richfacko-prog/rover1/3d/stl/upper_deck.stl

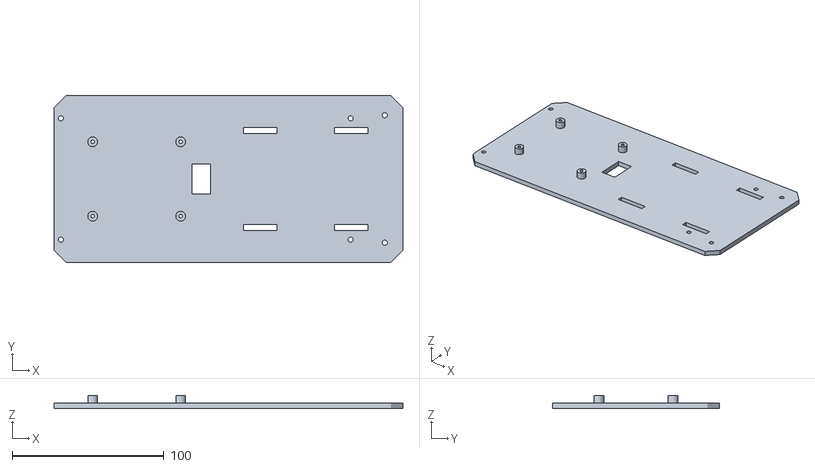
[picture p1: CAD file, 2026-11-14]
3d/stl/upper_deck.stl
230.0 x 110.0 x 8.50
