richfacko-prog/rover1/3d/stl/lower_deck.stl

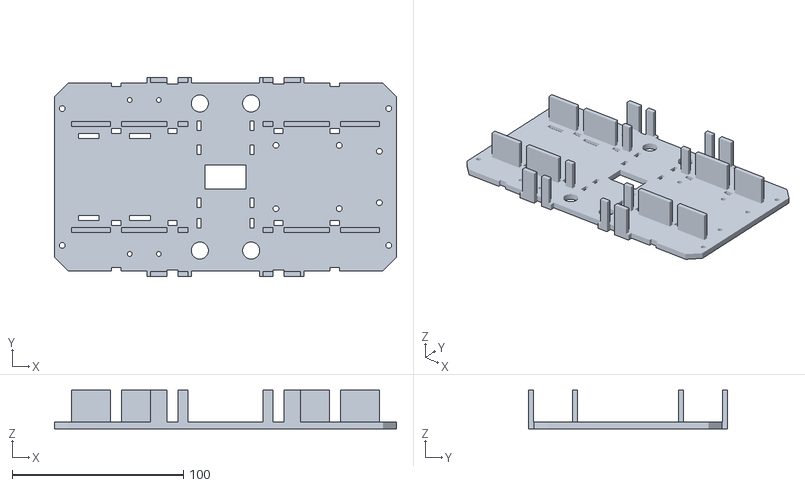
[picture p2: CAD file, 2026-11-13]
3d/stl/lower_deck.stl
200.0 x 116.6 x 22.8
