richfacko-prog/rover1/3d/stl/gauge_bracket.stl

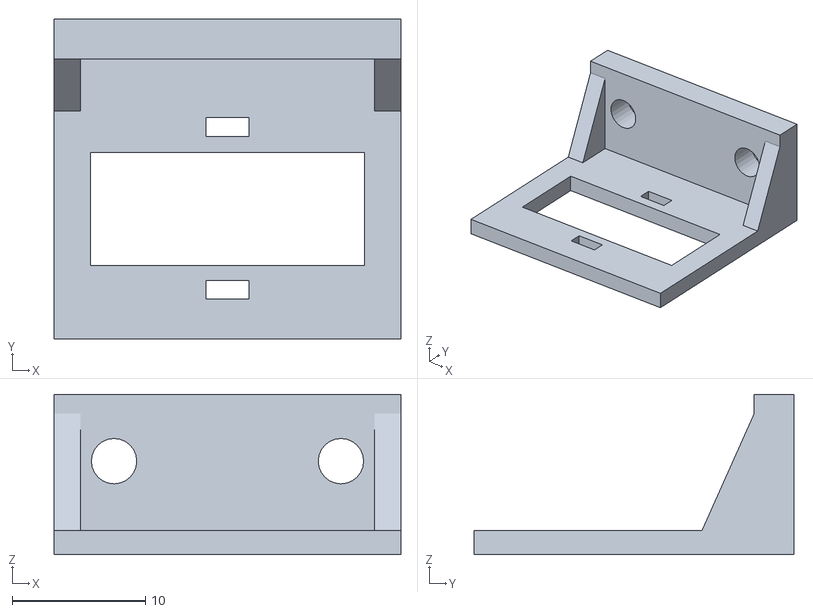
[picture p3: CAD file, 2026-11-12]
3d/stl/gauge_bracket.stl
26.0 x 24.0 x 12.0
