richfacko-prog/rover1/3d/stl/switch_bracket.stl

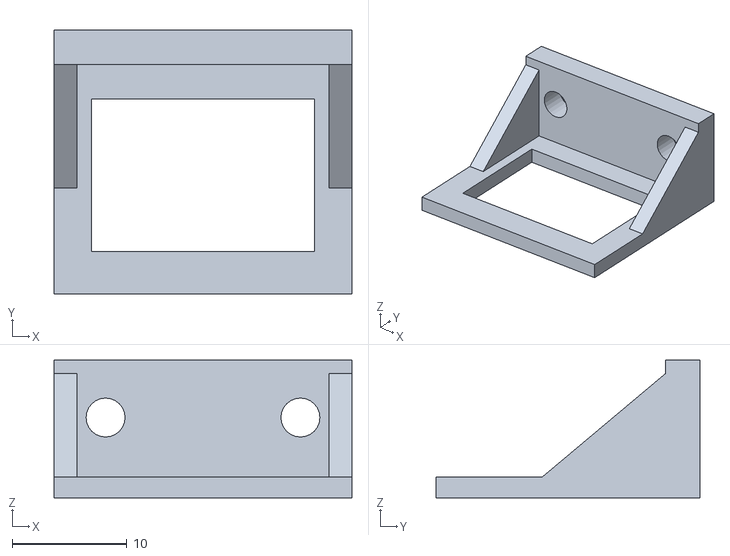
[picture p4: CAD file, 2026-11-12]
3d/stl/switch_bracket.stl
26.0 x 23.0 x 12.0
