richfacko-prog/rover1/3d/stl/pi_case_base.stl

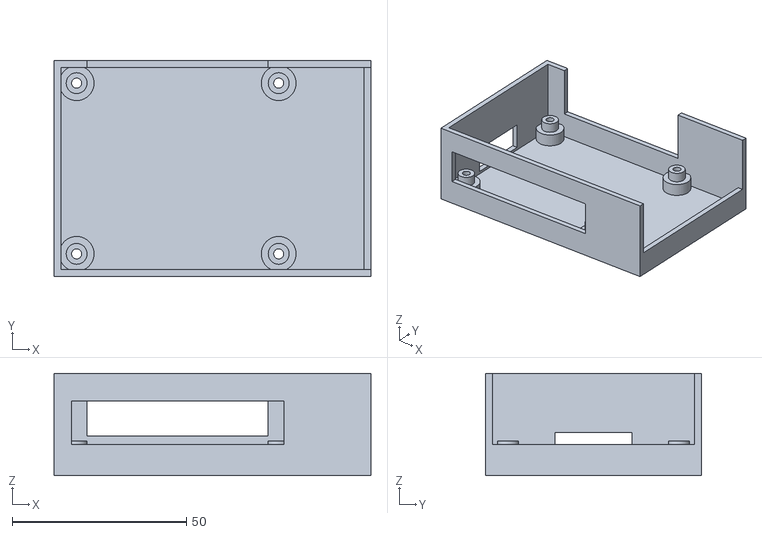
[picture p5: CAD file, 2026-11-09]
3d/stl/pi_case_base.stl
91.0 x 62.0 x 29.4
