richfacko-prog/rover1/3d/stl/deck_posts_x4.stl

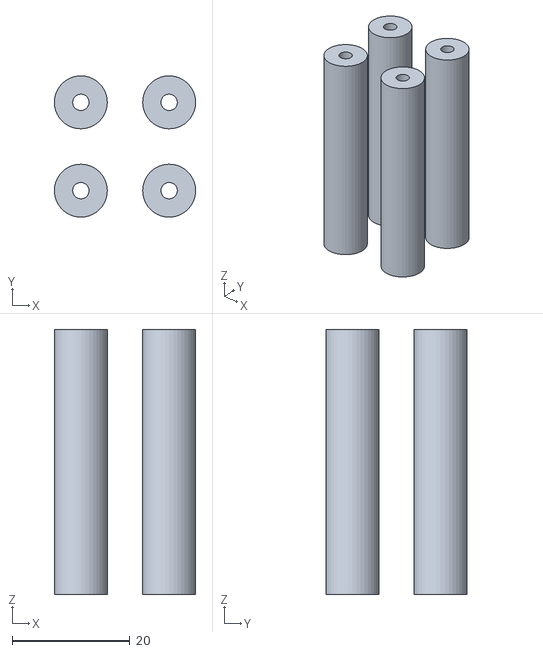
[picture p6: CAD file, 2026-11-09]
3d/stl/deck_posts_x4.stl
24.0 x 24.0 x 45.0
