richfacko-prog/rover1/3d/stl/tilt_bracket.stl

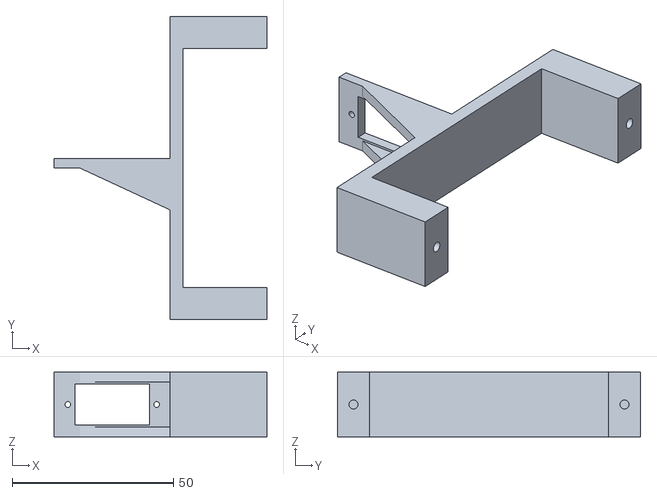
[picture p7: CAD file, 2026-11-09]
3d/stl/tilt_bracket.stl
66.0 x 94.0 x 20.0
