richfacko-prog/rover1/3d/stl/tilt_head.stl

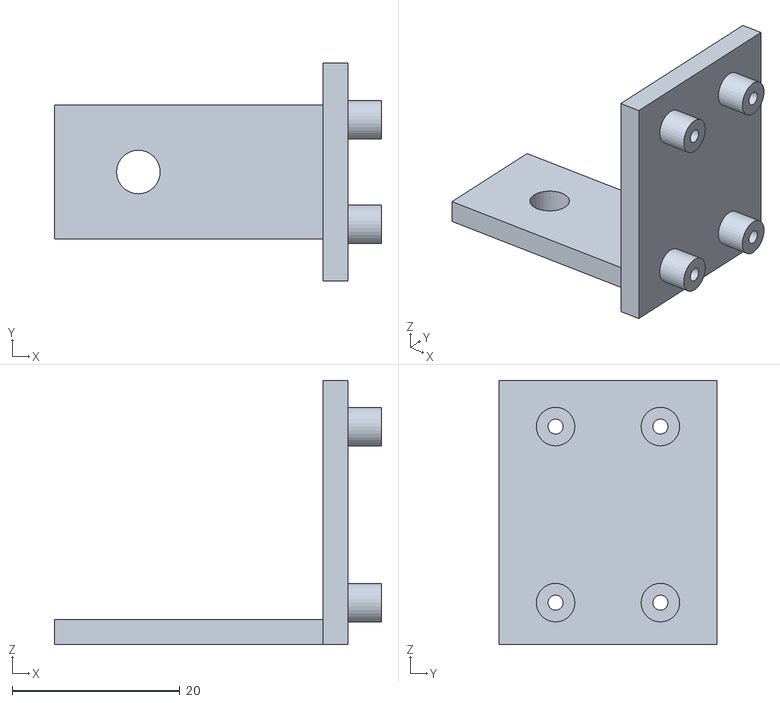
[picture p8: CAD file, 2026-11-09]
3d/stl/tilt_head.stl
39.0 x 26.0 x 31.5
