richfacko-prog/rover1/3d/stl/pi_case_lid.stl

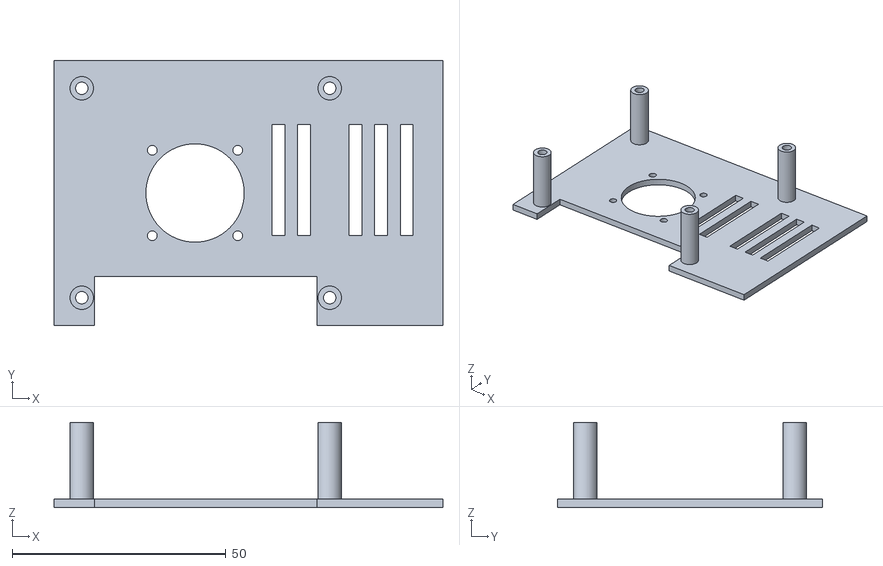
[picture p9: CAD file, 2026-11-09]
3d/stl/pi_case_lid.stl
91.0 x 62.0 x 20.0
