richfacko-prog/rover1/3d/stl/deck_posts_x2.stl

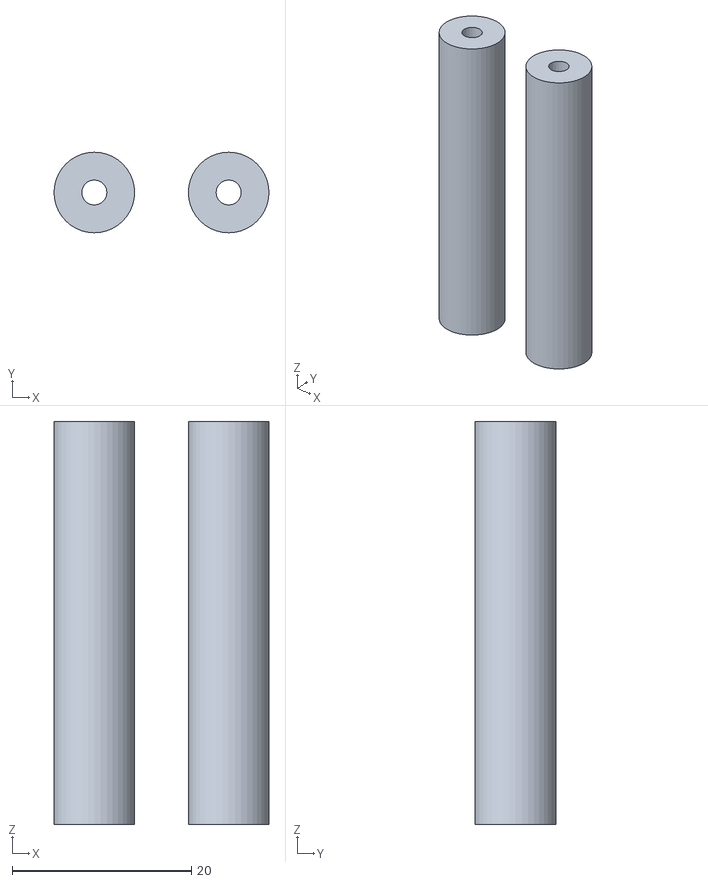
[picture p10: CAD file, 2026-11-09]
3d/stl/deck_posts_x2.stl
24.0 x 9.00 x 45.0
