richfacko-prog/rover1/3d/stl/camera_mount.stl

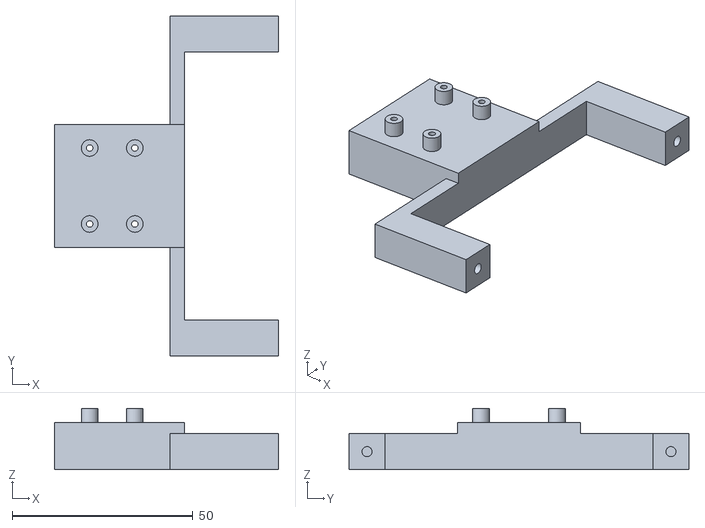
[picture p11: CAD file, 2026-11-09]
3d/stl/camera_mount.stl
62.0 x 94.0 x 17.0
