richfacko-prog/rover1/3d/stl/sensor_bracket.stl

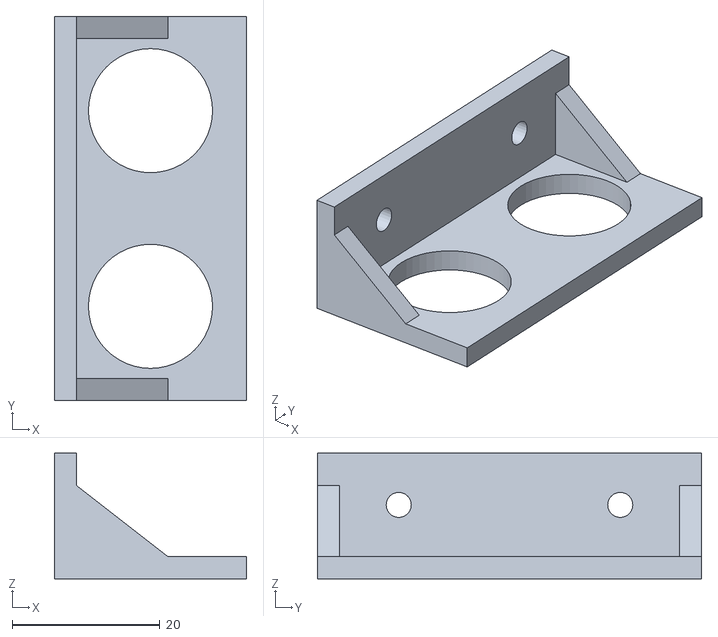
[picture p12: CAD file, 2026-11-09]
3d/stl/sensor_bracket.stl
26.0 x 52.0 x 17.0
