richfacko-prog/rover1/3d/stl/pi_case_bolt_lid.stl

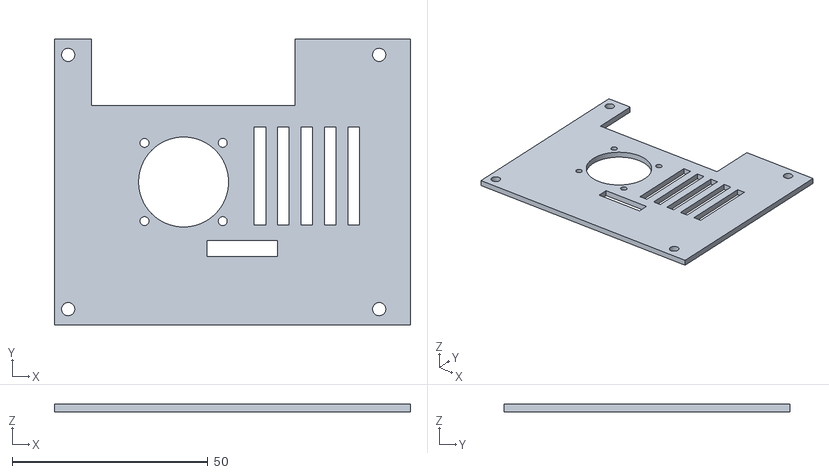
[picture p13: CAD file, 2026-11-10]
3d/stl/pi_case_bolt_lid.stl
91.0 x 73.0 x 2.00
