richfacko-prog/rover1/3d/stl/pi_case_bolt_base.stl

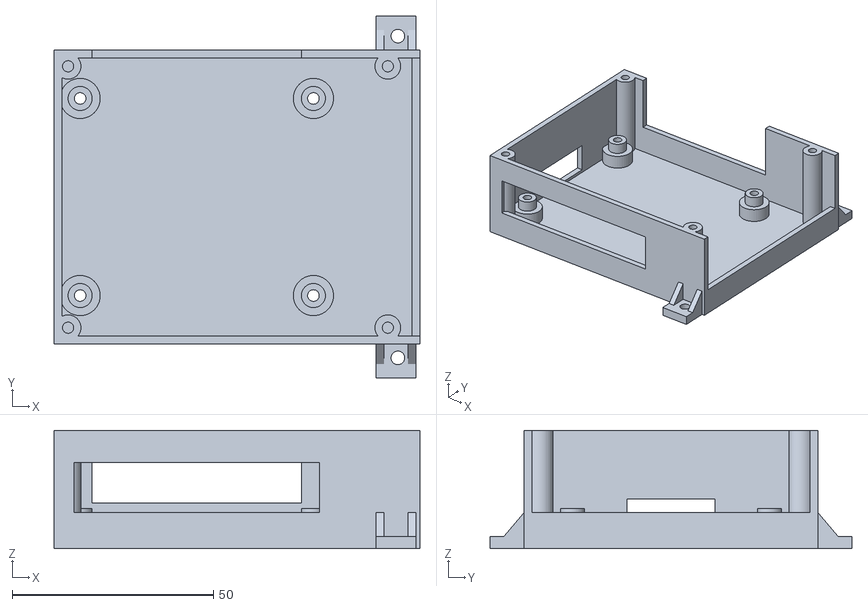
[picture p14: CAD file, 2026-11-10]
3d/stl/pi_case_bolt_base.stl
91.0 x 90.0 x 29.4
