richfacko-prog/rover1/(commit log)

2026-11-09 First upload from the PC master folder
    [camera_mount.stl, deck_posts_x2.stl, deck_posts_x4.stl, lower_deck.stl, pi_case_base.stl, pi_case_lid.stl, sensor_bracket.stl, tilt_bracket.stl]
2026-11-10 Update from PC: 3d/pi_case_bolt.py, 3d/stl/README.md, 3d/stl/pi_case_bolt_base.stl, 3d/stl/pi_case_bolt_lid.stl
    [pi_case_bolt_base.stl, pi_case_bolt_lid.stl]
2026-11-11 Update from PC: 3d/chassis.py, 3d/stl/README.md, 3d/stl/lower_deck.stl
    [lower_deck.stl]
2026-11-12 Update from PC: 3d/chassis.py, 3d/stl/README.md, 3d/stl/gauge_bracket.stl, 3d/stl/switch_bracket.stl
    [gauge_bracket.stl, switch_bracket.stl]
2026-11-13 Update from PC: 3d/stl/lower_deck.stl
    [lower_deck.stl]
2026-11-14 Update from PC: 3d/chassis.py, 3d/stl/upper_deck.stl
    [upper_deck.stl]
